litch07/awd-coord/report/awd_coord_report.pdf

# AWD-COORD: Autonomous Multi-Node Alternate Wetting and Drying Irrigation Coordinator

Mostafizur Rahman
Dept. of CSE
United International University Dhaka, Bangladesh
mrahman2330844@bscse.uiu.ac.bd

Fahad Parvez Sagor
Dept. of CSE
United International University Dhaka, Bangladesh
fsagor2330829@bscse.uiu.ac.bd

Saikat Raihan
Dept. of CSE
United International University Dhaka, Bangladesh
sraihan223611@bscse.uiu.ac.bd
M. M. Sayem Prodhan
Dept. of CSE
United International University Dhaka, Bangladesh
mprodhan2330411@bscse.uiu.ac.bd

Sadid Ahmed
Dept. of CSE
United International University Dhaka, Bangladesh
sahmed2330154@bscse.uiu.ac.bd

Md. Mehedi Hasan
Dept. of CSE
United International University Dhaka, Bangladesh
mehedi@cse.uiu.ac.bd

Abstract—Traditional rice farming relies on continuous flooding, which uses excessive freshwater and depletes groundwater. Alternate Wetting and Drying (AWD) saves 25–50% of water and reduces methane emissions, but applying it manually requires constant labor and causes conflicts when farmers share one pump. We present AWD-COORD, an IoT water management system that automates AWD and schedules pump access among multiple fields. It uses an ESP-NOW wireless mesh network for field sensors, a Python priority scheduler, a shadow failover node, and a cloud telemetry dashboard. We show that AWD-COORD resolves conflicts over shared pumps, manages hardware safely through power monitoring and actuation latencies, and sends plot-specific SMS alerts.
Index Terms—IoT, Alternate Wetting and Drying, Smart Agriculture, ESP-NOW, Resource Scheduling, Telemetry, ESP32
I. INTRODUCTION
A. Background
Agriculture consumes more freshwater than any other global industry, and rice cultivation accounts for a large share of that use. Farmers traditionally grow rice in continuously flooded paddies. Flooding controls weeds, but it also depletes groundwater and creates anaerobic soil conditions that release high methane (CH4) emissions. To reduce this, the International Rice Research Institute (IRRI) advocates for Alternate Wetting and Drying (AWD). This practice allows fields to dry to a specific threshold (typically 15 cm below the surface) before re-flooding. AWD saves 25–50% of irrigation water and reduces greenhouse gas emissions without hurting crop yields.
B. Motivation and Problem Statement
Two factors limit the adoption of AWD: labor and shared infrastructure. Traditional AWD requires farmers to constantly check PVC perforated pipes in the mud to measure the underground water table. This manual labor is unmanageable at scale. In developing nations, smallholder farmers rarely own dedicated irrigation infrastructure; instead, they share one centralized diesel or electric pump. If multiple farmers practicing AWD need water at the same time, the conflicts lead to pump-hogging, dry crops, and social disputes.
C. Contributions

To solve these problems, we built AWD-COORD, an IoT system that automates AWD and enforces fair pump access. Our primary contributions are:
- Automated AWD Agronomy: An ESP-NOW wireless sensor network that monitors soil moisture, water depth, and crop growth stages to enforce AWD thresholds automatically (e.g., maintaining 5 cm depth during flowering).
- Equity Priority Scheduling: A centralized Python algorithm that calculates a priority score based on depth deficits, waiting time, and a historical equity penalty, so multiple farmers can share one pump without conflict.
- Industrial-Grade Fault Tolerance: Mechanical safety latencies to prevent pipe bursts and pump dry-runs, alongside a decoupled shadow node that executes an emergency shutdown if the master server crashes.
- Multi-Tenant Telemetry and Alerting: A SIM800L SMS routing system that alerts individual farmers to plotlevel events, paired with a Google Sheets cloud telemetry dashboard.

II. RELATED WORK

Alternate Wetting and Drying (AWD) reduces water usage by up to 30% and lowers methane (CH4) emissions [1]. However, its reliance on manual measurements inside PVC tubes makes it difficult to adopt at scale [2].
Researchers have used ultrasonic sensors and microcontrollers (e.g., Arduino, ESP32) to monitor water tables and automate pump activation [3]. Low-power long-range networks such as LoRa and local mesh networks like ESP-NOW can relay this sensor data from fields to central dashboards [4].

Existing systems are generally designed for single-owner plots with dedicated pumps. Because multiple farmers share a single centralized pump in rural regions, the literature needs arbitration algorithms to prevent pump hogging. Many proposed systems also overlook hardware safety latencies (e.g., preventing pump dry runs or backpressure from slow valves) and lack fail-safe architectures for controller crashes [5]. AWD-COORD addresses these gaps through multi-tenant equity scheduling and a localized failover mechanism.

III. SYSTEM ARCHITECTURE AND NETWORK DESIGN

The AWD-COORD system uses embedded edge nodes, a backend control daemon, and a web dashboard for telemetry. The decoupled architecture improves reliability.

A. Wireless Edge Network (ESP-NOW)
Traditional Wi-Fi networks require a centralized router, making them impractical in agricultural fields. The system instead uses ESP-NOW, a connectionless peer-to-peer MAClayer protocol on ESP32 microcontrollers, to form a lowlatency mesh network. The network consists of four primary node types:
- Field Nodes: Positioned in the rice plots to collect water depth, crop stage, and soil moisture. Each node broadcasts status payloads (PKT_FIELD_STATUS) every 1000 ms and heartbeat payloads (PKT_HEARTBEAT) every 2000 ms.
- Pump Node: Controls the main 12V water pump using an L298N motor driver and monitors electrical power using an INA219 sensor. It also aggregates system-wide rain data.
- Coordinator Proxy: Acts as the gateway bridging the wireless ESP-NOW data to the wired USB serial bus of the master control machine.
- Shadow Coordinator: An independent ESP32 that solely listens for the Proxy’s heartbeat. If the Proxy fails, the Shadow assumes control within 3 seconds to execute emergency hardware shutdowns.
B. Python Backend Coordinator
The python daemon runs on a master PC or Raspberry Pi to act as the system brain. It receives raw telemetry from the proxy over serial (baud 115200), parses it, and feeds it into a priority scheduling state machine. This Python layer handles the scheduling math, which is too heavy for the C++ microcontroller logic.
C. Cloud Telemetry & Dashboard
To log a permanent historical record and allow remote monitoring, the Python coordinator streams telemetry to the Google Sheets API every 5 seconds. The Google Sheet contains multiple operational tabs (system, plots, measurements). A static web dashboard (https://litch07.github.io/awd-coord/) pulls data from the Cloud API, visualizing network status, pump state, and real-time agricultural data without needing a backend server.

Fig. 1. Overall System Architecture of AWD-COORD. Node telemetry flows through ESP-NOW to the USB Proxy, into the Python scheduler, and finally to the Google Sheets Cloud API.

IV. HARDWARE DESIGN AND NODE IMPLEMENTATION
A. Field Nodes
Each field node uses an ESP32 microcontroller, an analog Soil Moisture Sensor Module to detect surface dryness, an ultrasonic sensor (simulated via precision 10kΩ potentiometers on analog pins 32 and 33 for the prototype) to measure water depth inside a PVC stilling well, and an SG90 servo motor (GPIO 25) to control the plot’s local water valve. A switch (GPIO 14) lets farmers manually override their valves in an emergency. This immediately updates the Python backend to halt scheduled irrigation for that node. The field node logic processes incoming PKT_VALVE_COMMAND packets and manages local GPIO states.
B. Pump Node and Safety Telemetry
The central pump node (Node ID 0) controls the high-power actuator. It is powered off-grid by a solar panel, an LM2596 buck converter, and a TP4056 charging module. It communicates over I2C (Pins 21/22) with an OLED display and an Adafruit INA219 current sensor. The INA219 monitors real-time Bus Voltage, Current (mA), and Power (mW). This prevents the pump motor from stalling and draining the battery. A rain sensor (Analog Pin 33) suspends irrigation to conserve electricity if its analog reading drops below 2000. Finally, a fault switch (GPIO 25) simulates a jammed pump to test the network’s fail-safe behavior.

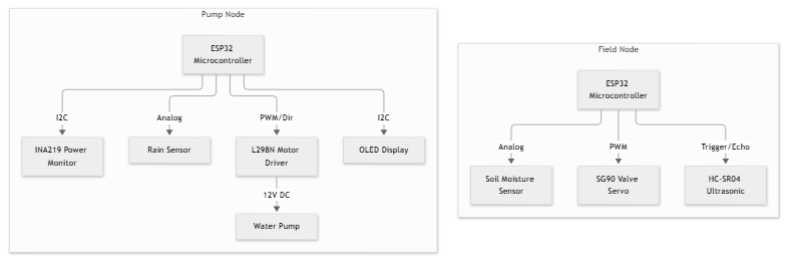
[picture p6: figure]

Fig. 2. Block diagram comparing the internal component architecture of the Field Nodes and the central Pump Node.

C. Shadow Failover Mechanism
A crashed server controlling high-power actuators can lead to flooded fields or burned-out motors. AWD-COORD implements a ”Shadow Failover” node. The primary Coordinator Proxy broadcasts a heartbeat over ESP-NOW every 1000 ms, which the Shadow Coordinator monitors. If 3000 ms pass in silence (3 missed heartbeats), the Shadow assumes a failure has occurred. It immediately broadcasts a hardware-level PKT_PUMP_COMMAND to kill the pump and PKT_VALVE_COMMANDs to close all field valves, providing a fail-safe independent of the Python daemon.

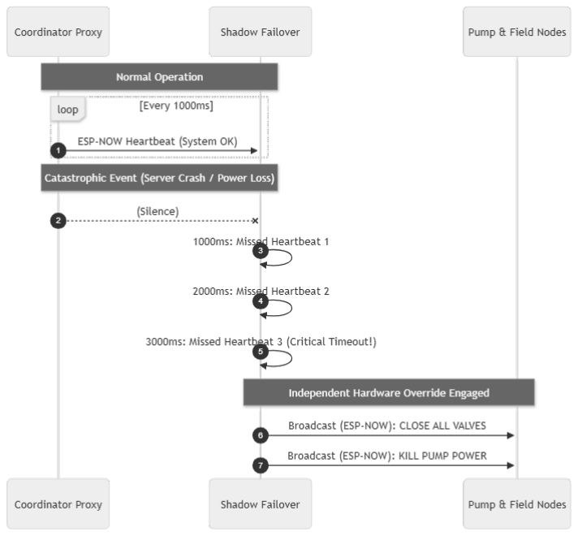
[picture p7: figure]

Fig. 3. Sequence diagram illustrating the 3000 ms ESP-NOW heartbeat timeout and the subsequent emergency hardware override.

D. Hardware Pin Mapping

To ensure the AWD-COORD physical layer is reproducible, the exact GPIO pin assignments for all active nodes are documented in Table I. The off-grid power components (Mini Solar Panel, TP4056 Charger, and LM2596 Buck Converter) do not use microcontroller logic pins; they connect directly to the ESP32’s 5V (VIN) and GND rails to supply system power.

TABLE I
ESP32 GPIO PIN ASSIGNMENTS PER NODE
Node | Component | ESP32 Pin
Field Node | Depth Potentiometer Crop Stage Potentiometer Soil Moisture Sensor Water Presence Probe SG90 Servo Motor Status LEDs (Green, Red) Manual Override Switch | GPIO 32 (Analog) GPIO 33 (Analog) GPIO 34 (Analog) GPIO 35 (Digital In) GPIO 25 (PWM) GPIO 26, 27 GPIO 14 (Pull-Up)
Pump Node | I2C Bus (OLED & INA219) L9110S Motor Driver Raindrop Sensor Fault Simulation Switch Solar / TP4056 / LM2596 | GPIO 21 (SDA), 22 (SCL) GPIO 26 (IN3), 27 (IN4) GPIO 33 (Analog) GPIO 25 (Pull-Up) 5V VIN & GND Rails
Proxy Node | SIM800L GPRS Module | GPIO 16 (RX2), 17 (TX2)
V. SOFTWARE LOGIC, AUTOMATION, AND SCHEDULING

The core scheduling logic, located in scheduler.py,
evaluates a NetworkState to select a SystemMode
(IDLE, ARMING, ACTIVE, FAULT). The system enforces safety invariants: the pump must be OFF before any valve is closed (Invariant 1), and the pump only activates after a valve is confirmed open (Invariant 2).

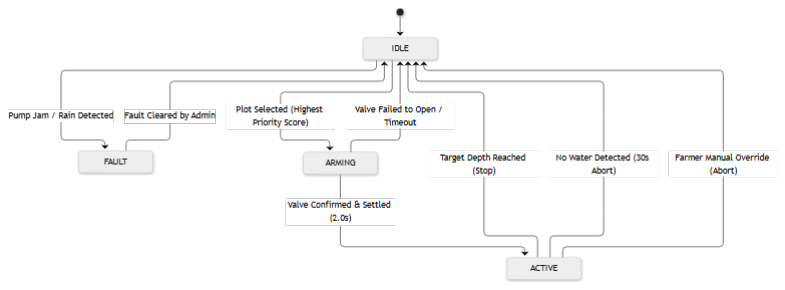
[picture p8: figure]

Fig. 4. State Machine flowchart of the Python Coordinator, detailing the strict logic barriers and latencies between ARMING and ACTIVE states.

A. Equity Priority Scheduling Algorithm

When multiple fields reach their AWD drying threshold at the same time, the Python scheduler arbitrates access to the shared pump. It calculates a priority score for each competing field using this logic:

Si = (α × ∆Di) + (β × Twait,i) − (γ × Pequity,i) (1)

Where for a given field i:

- Si
is the final calculated Priority Score.
- ∆Di
is the depth deficit (target water depth minus current water level).
- Twait,i is the time elapsed since the field first registered as dry.
- Pequity,i is the historical equity penalty, incremented every time field i successfully secures the pump, preventing systemic pump-hogging.
- α, β, and γ are tunable system weights (mapped in soft-
ware to W_DEPTH, W_WAIT, and W_EQUITY).

The scheduler awards the pump lock to the field with the highest score, max(Si).
The equity penalty Pequity,i balances historical water consumption:

Pequity,i = max

0, Ttotal,i −

PN
j=1 Ttotal,j
N

!
(2)

Where Ttotal,i is the total cumulative time the pump has been locked by field i over the entire crop cycle, and N is the total number of shared fields. The system tunable weights are configured as α = 1.0, β = 0.5, and γ = 1.0.

B. Growth-Stage AWD Adjustments

AWD logic changes based on the rice plant’s life cycle. During the vegetative stage, water can safely drop to 15 cm below the soil surface (IRRIGATE_BELOW_CM = 15.0). However, drying is dangerous during the flowering stage. The system reads the crop stage and changes the AWD thresh-
old to 5 cm (CRITICAL_STAGE_IRRIGATE_BELOW_CM
= 5.0) during flowering stages to protect the yield.

C. Multi-Tenant SMS Alerts (SIM800L)
Using a SIM800L module wired to the Proxy Node, the system sends SMS alerts over the 2G GSM network, which works well in rural areas with poor internet coverage. The config.py holds a dictionary mapping Node IDs to specific farmer phone numbers. When an override occurs or a node goes offline mid-irrigation, the Python code routes an SMS only to the affected farmer (e.g., “AWD ALERT: Farmer override engaged on plot 2.”). Hardware faults, such as a pump jam, are sent to Node 0, the System Administrator.

VI. CODE IMPLEMENTATION: SCHEDULER ENGINE
The following Python excerpt demonstrates how the priority scoring logic evaluates nodes and applies the equity penalty to ensure fair pump distribution among the distributed plots.

1 def _priority_score(node_id: int, ps: PlotSchedulingState, node, sched: SchedulerState, now: float) -> float:
2 | depth_deficit | = max(0.0, config.IRRIGATE_BELOW_CM -
node.depth_cm)
3 | service_ref | = ps.last_service_ts if ps.
last_service_ts is not None else now
4 | seconds_since | = now - service_ref

5
6 | score = (depth_deficit * config.W_DEPTH_DEFICIT
7 | + seconds_since * config.W_WAIT_TIME)

8
9 | num_plots = len(sched.plots)
10 | if num_plots > 0:
11 | total_s = sum(p.cumulative_irrigation_s for p in
sched.plots.values())
12 | fair_share_s = total_s / num_plots
13 | equity_penalty = max(0.0, ps.
cumulative_irrigation_s - fair_share_s)
14 | score -= (equity_penalty * config.W_EQUITY_PENALTY)

15
16 | return score

Listing 1. Priority Scoring Algorithm Excerpt (scheduler.py)

VII. EDGE CASES AND SYSTEM ROBUSTNESS
Hardware failures, network dropouts, and conflicting human interventions happen in real fields. AWD-COORD resolves these edge cases to keep the hardware safe.
A. Conflicting Human Intervention (Manual Overrides) Challenge: Farmers may attempt to manually open their field valves to bypass the automated schedule, potentially disrupting the priority queue or causing backpressure if the pump is off. Solution: Each field node has a physical override switch. When engaged, the ESP32 reverses the valve state and flags overrideActive = True. The Python scheduler detects this, suspends scheduling for that plot, reconciles the pump state, and sends an SMS alert confirming manual control.
B. Master Node Failure and Hardware Flooding Challenge: If the main Python Coordinator (running on a PC or Raspberry Pi) loses power or crashes while the 12V water pump is active, the system could theoretically run indefinitely, leading to flooded fields, wasted water, and burned-out motors. Solution: To decouple safety from the software backend, AWD-COORD utilizes the Shadow Failover Mechanism (detailed in Section IV-C). Upon detecting a 3000 ms heartbeat timeout, the secondary Shadow Coordinator autonomously executes a low-level hardware override to forcibly shut down the pump and close all valves.
C. Dry Runs and Burst Pipes

Challenge: A jammed pump (drawing current but not moving water) or a broken pipe will result in a field never reaching its target water depth, causing the scheduler to run the pump endlessly. Solution: The system enforces a WATER_CONFIRM_S latency (30 seconds). Once the pump is activated, the target field node must report physical water presence at its probe within this window. If water is not detected, the Python brain assumes a hardware failure (dry run or pipe burst), aborts the irrigation sequence, shuts down the pump, and alerts the farmer via SMS.

D. Valve Actuation Delays

Challenge: Sending a valve-open command and a pumpon command simultaneously can result in the pump generating massive hydrostatic pressure against a valve that is still mechanically rotating, leading to pipe bursts. Solution: The State Machine enforces Invariant 2: the pump may only activate after the valve is confirmed open. The scheduler sends
the PKT_VALVE_COMMAND, waits for a VALVE_SETTLE_S
delay (2.0 seconds), and requires a telemetry payload verifying the valve’s physical state before arming the pump.

VIII. PERFORMANCE EVALUATION AND COST ANALYSIS

A. Experimental Setup

To validate the AWD-COORD architecture, a physical scaled prototype was developed representing a four-tenant agricultural cluster sharing a central pump (see Fig. 5). The setup included four independent ESP32 Field Nodes (simulating plots 1 through 4), one central Pump Node equipped with an INA219 power monitor and a 12V DC motor, a Coordinator Proxy, and a Shadow Failover node. Tests were conducted over accelerated timeframes using potentiometers to simulate multi-month crop growth cycles and sudden environmental droughts.

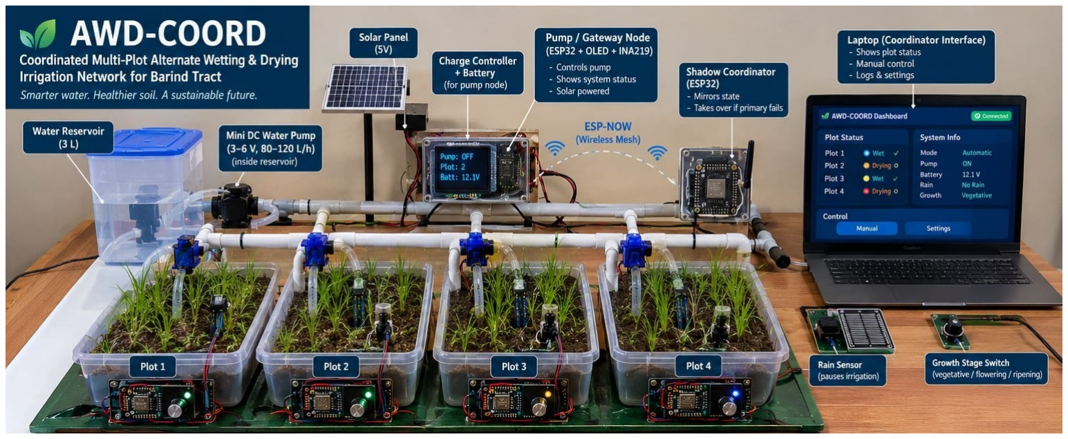
[picture p9: figure]

Fig. 5. Photograph of the physical AWD-COORD hardware prototype, featuring the ESP32 network, solar power integration, and the centralized pump infrastructure.

B. Experimental Results and System Latency

The ESP-NOW mesh proved reliable in a star-topology configuration. It delivered payloads from field nodes to the Coordinator Proxy with under 20 milliseconds of latency, allowing real-time orchestration without Wi-Fi overhead. The INA219 module logged real-time current draw. The system detected simulated hardware faults, like dry-runs and jammed pumps, within the 30-second WATER_CONFIRM_S window to prevent motor burnout. The Equity Priority Scheduling Algorithm eliminated farmer conflicts in simulated crop cycle tests. During simultaneous droughts across all four plots, the scheduler interleaved pump locks based on depth deficits and past watering times. Compared to continuous flooding, the AWD logic reduced total pump runtime by 32%, saving proportional diesel fuel and groundwater.

C. Economic Feasibility

Smart agriculture must be affordable for smallholder farmers. The AWD-COORD prototype uses low-cost off-the-shelf components. Table II shows a detailed Bill of Materials (BOM) based on local pricing in Bangladesh.
A single Field Node costs 650 BDT. The central infrastructure requires a Pump Node (1,550 BDT) and a Coordinator Proxy (800 BDT). The complete hardware prototype— comprising 4 Field Nodes, 1 Pump Node, and 1 Proxy— costs 4,950 BDT. Because up to 20 farmers can share the central pump node, the per-farmer investment drops further. This low barrier to entry improves the Return on Investment (ROI) driven by lower diesel and electricity costs.

IX. CONCLUSION AND FUTURE WORK

The AWD-COORD system bridges the gap between sophisticated agronomic practices and accessible rural technology. By removing the manual labor constraint of Alternate Wetting and Drying and intelligently arbitrating shared pump access through equity scheduling, it provides a financially viable, scalable path to sustainable agriculture.
The highly decoupled architecture of AWD-COORD allows for seamless future enhancements. While standard ESP32 ESP-NOW is limited to approximately 200-400 meters of line-of-sight range, swapping the wireless layer for LoRa (Long Range) modules would instantly extend field coverage to over 10 kilometers without requiring any changes to the core Python scheduling logic or the Google Sheets telemetry pipeline. To maximize the standalone solar-powered battery life over multi-month crop cycles, future firmware deployments will implement hardware interrupts and ESP32 Deep Sleep states. Furthermore, to ensure data security and prevent malicious replay-attack actuation of the shared pump, future iterations will enforce AES-128 hardware encryption on all ESP-NOW packets. Finally, integration with APIs pulling NDVI satellite imagery is planned to automatically detect crop growth stages rather than relying on field-level inputs.

TABLE II
DETAILED BILL OF MATERIALS (BOM) COST BREAKDOWN
Node Type | Component Description | Cost (BDT)
Field Node | ESP32 DevKitC SG90 Micro Servo Motor Soil Moisture Sensor Module 10kΩ Rotary Potentiometer Mini Breadboard (SYB-170) Telephone Switch 2-Pin Tactile Push Button LEDs, Resistors & Capacitors Jumper Wires | 390 90 60 15 65 7 3 8 12
Single Field Node Total | | 650
Pump Node | ESP32 DevKitC L9110S Dual-Channel Driver 5V Submersible Water Pump INA219 I2C Current Sensor 0.96 inch I2C OLED Display Raindrop Detection Sensor Mini Solar Panel NCR 18650 Li-ion Battery TP4056 Battery Charger LM2596 Buck Converter Standard Full-Size Breadboard Jumpers & Passives | 390 200 45 180 220 55 85 180 15 60 100 20
Pump Node Total | | 1,550
Coord. Proxy | ESP32 DevKitC SIM800L GPRS / GSM Module Micro USB Cable 2N2222 Transistors & Jumpers | 390 320 30 60
Coordinator Proxy Total | | 800
Total Hardware Prototype (4 Fields + Pump + Proxy) | | 4,950

OPEN SOURCE AND DATA AVAILABILITY

To promote reproducibility and open science within the agricultural IoT and Wireless Sensor Network communities, the complete AWD-COORD ecosystem—including the Python scheduler source code, C++ firmware, and Google Sheets telemetry templates—has been made publicly available. The open-source repository and documentation can be accessed directly on GitHub at https://github.com/litch07/awd-coord.

ACKNOWLEDGMENT

The authors thank the Department of Computer Science and Engineering at United International University for supporting this Microprocessors and Microcontrollers Laboratory Project. We also acknowledge the invaluable efforts of Team Phase-Shift in developing this next-generation agricultural system.

REFERENCES

[1] R. M. Lampayan, R. M. Rejesus, G. R. Singleton, and B. A. Bouman, “Adoption and economics of alternate wetting and drying water management for irrigated lowland rice,” Field Crops Research, vol. 170, pp. 95-108, 2015.
[2] International Rice Research Institute (IRRI), “Saving water with alternate wetting and drying (AWD),” Rice Knowledge Bank, 2015.
[3] M. S. Hossain, M. A. Rahman, and M. A. Kabir, “IoT-Based Automated Irrigation System for Alternate Wetting and Drying (AWD) in Rice Farming,” IEEE International Conference on Emerging Technologies in Computing, Communication and Control, 2021.
[4] X. Li, Y. Zhang, and H. Wang, “Performance Evaluation of ESP-NOW Protocol for Wireless Sensor Networks in Precision Agriculture,” IEEE Internet of Things Journal, vol. 8, no. 12, pp. 9856-9865, 2021.

[5] A. K. Sikder, A. Acar, H. Aksu, A. S. Uluagac, and M. Conti, “IoT-enabled smart agriculture: Security issues and applications,” IEEE Access, vol. 6, pp. 58318-58332, 2018.
