litch07/awd-coord/website/assets/img/mustafiz.jpeg

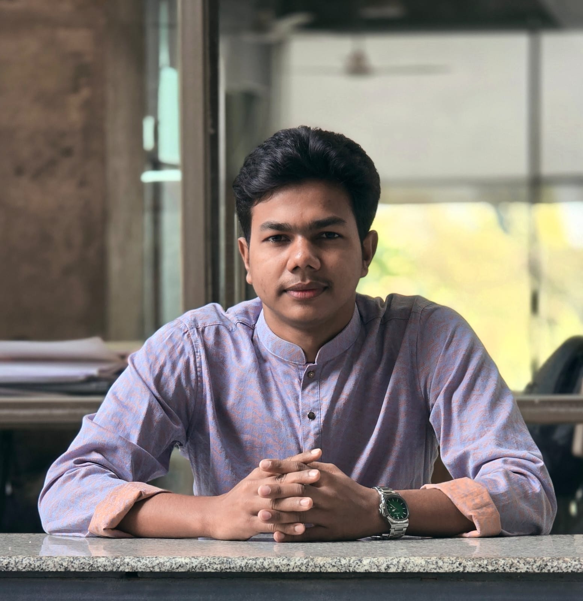
website/assets/img/mustafiz.jpeg
