litch07/awd-coord/website/assets/img/sagor.jpeg

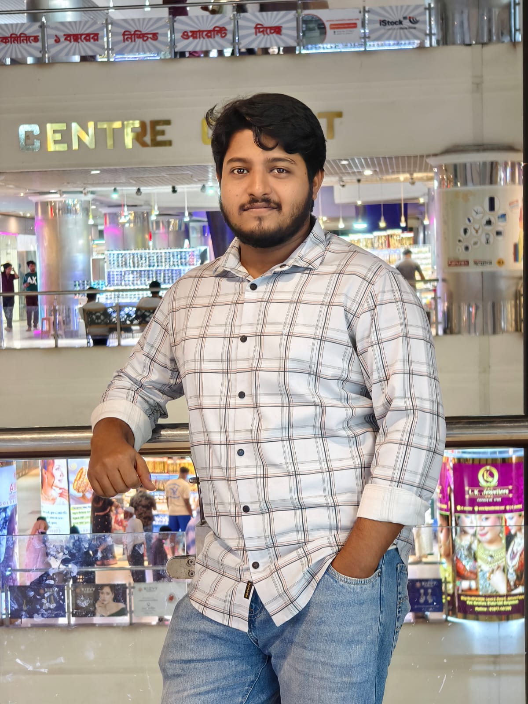
website/assets/img/sagor.jpeg
