litch07/awd-coord/website/assets/img/saikat.jpeg

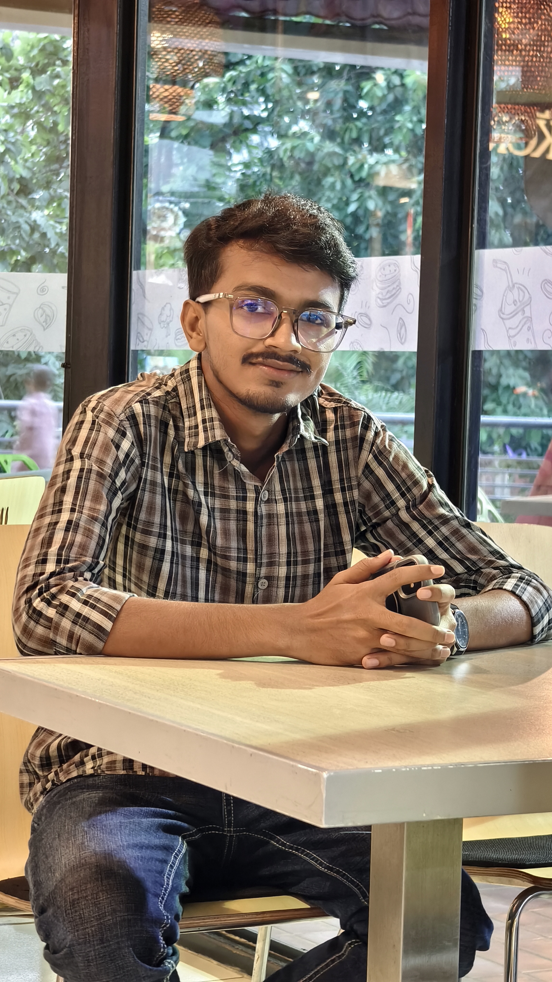
website/assets/img/saikat.jpeg
