litch07/awd-coord/website/assets/img/sayem.jpeg

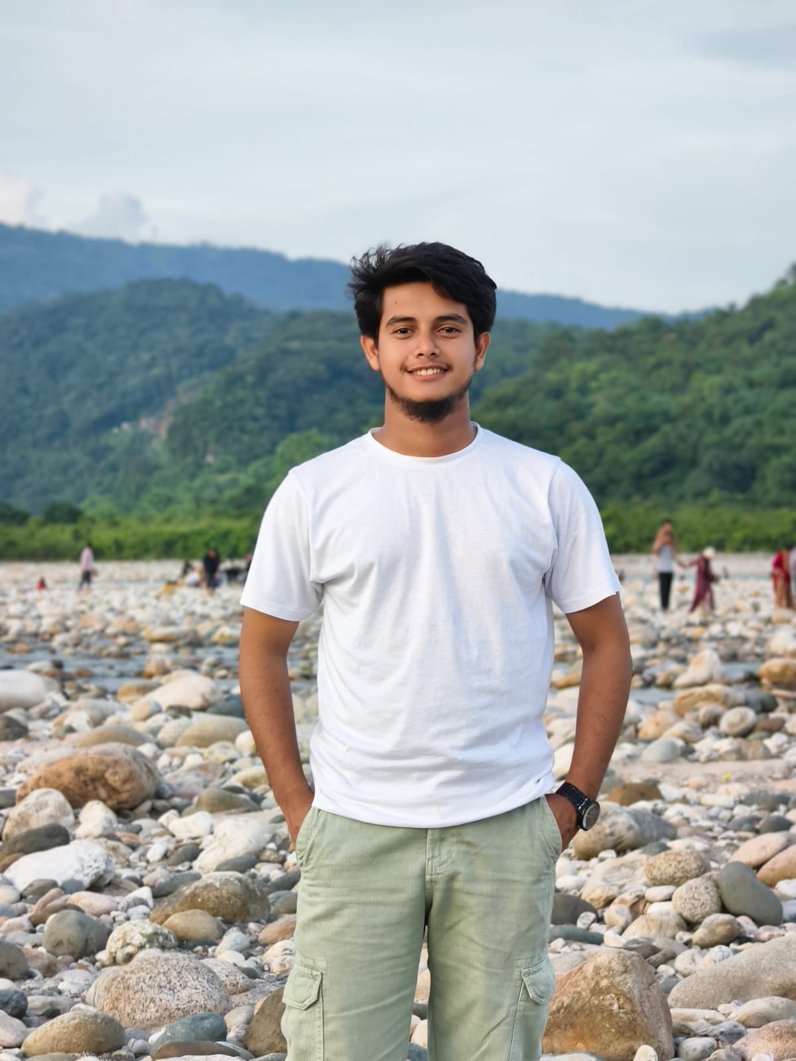
website/assets/img/sayem.jpeg
