litch07/awd-coord/website/assets/img/uiu.webp

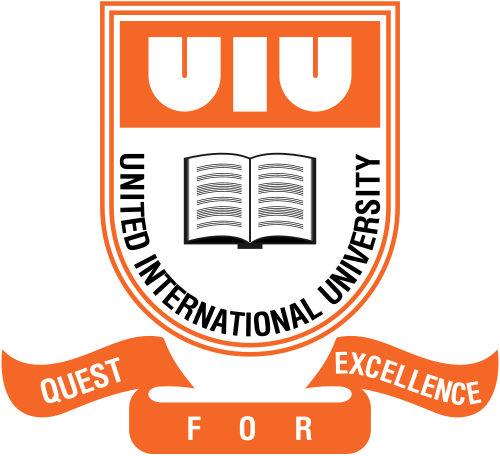
website/assets/img/uiu.webp
