litch07/awd-coord/(commit log)

2026-09-29 fix: update dashboard link status indicator and add soil moisture trigger for irrigation
    [scheduler.py]
2026-09-29 hardware: migrate pump logic to L298N motor driver
2026-09-29 firmware: fix esp-now callback signature in shadow coordinator
    [shadow_coordinator.ino]
2026-09-29 firmware: switch pump node to use L298N channel B
2026-09-29 fix(dashboard, uplink): improve staleness check, format timers, and add HA topology badge
    [sheets_uplink.py]
2026-09-30 chore: Finalize production firmware, P3 logic, SIM800L, and Shadow Failover
    [config.py, coordinator_proxy.ino, field_node_1.ino, field_node_2.ino, field_node_3.ino, field_node_4.ino, mac_lookup.ino]
2026-10-06 docs: Add telemetry template and humanized AWD-COORD technical report
    [AWD-COORD_Telemetry_Template.xlsx]
