litch07/awd-coord/website/assets/img/sadid.jpeg

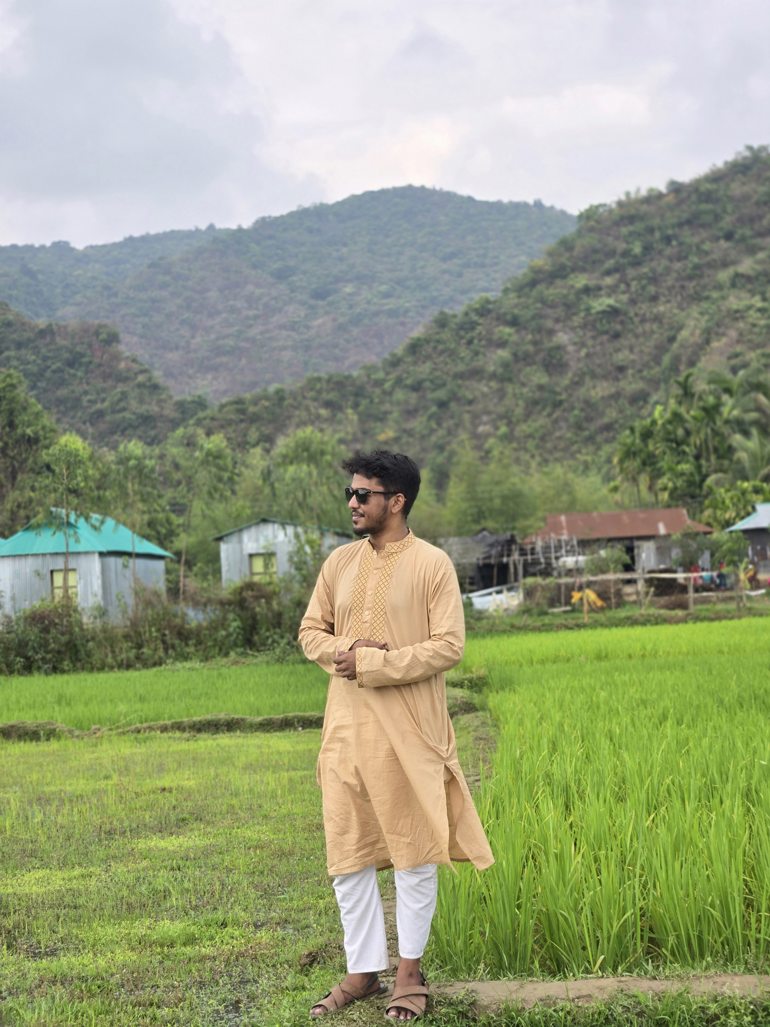
website/assets/img/sadid.jpeg
